anmolagarwal04/IC-Tester/design.pdf

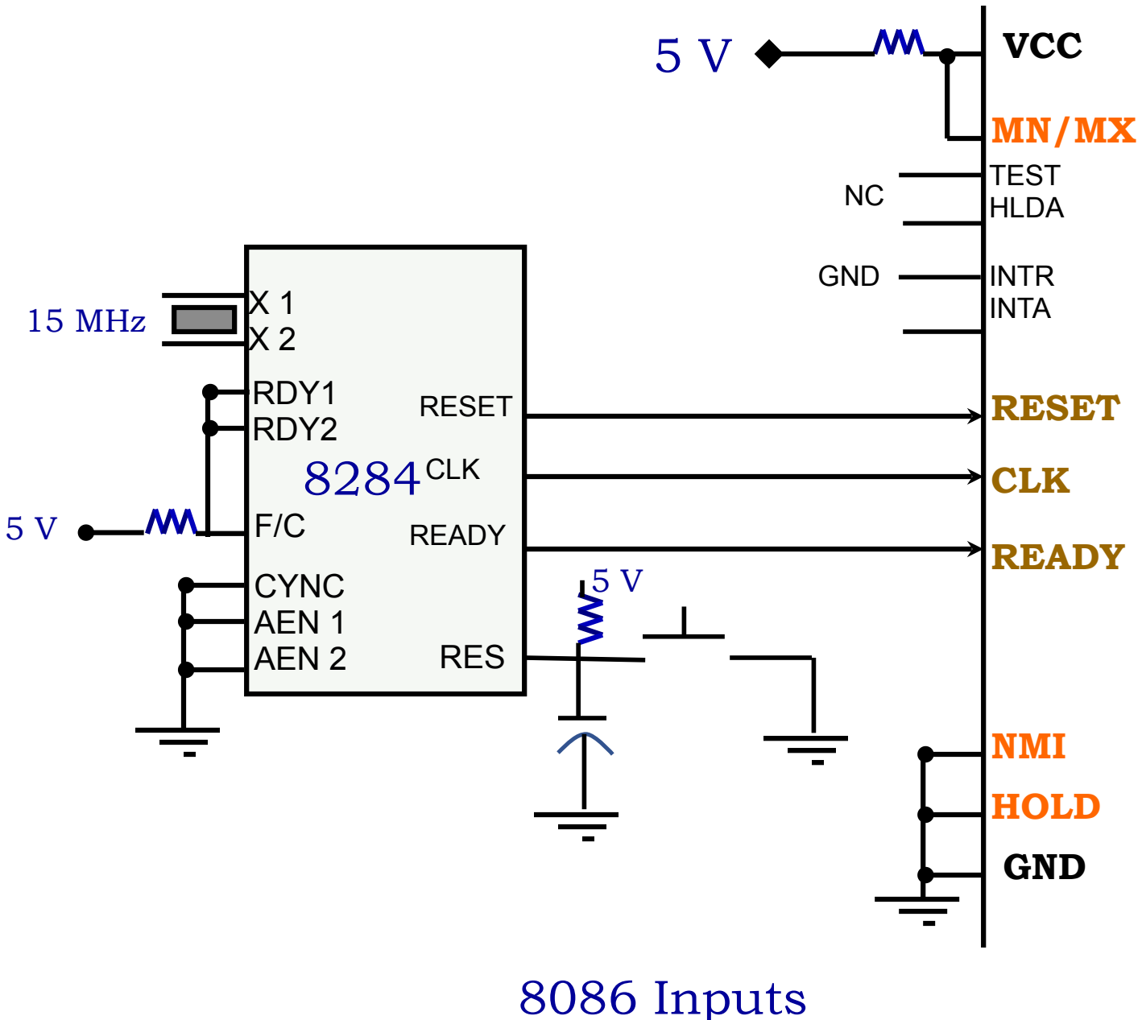
[picture p1: figure]
CLK; RESET; READY; VCC; GND; HOLD; NMI; 15 MHz; 8086 Inputs; CYNC AEN 1 AEN 2; RES; RDY1 RDY2; TEST HLDA; INTR INTA

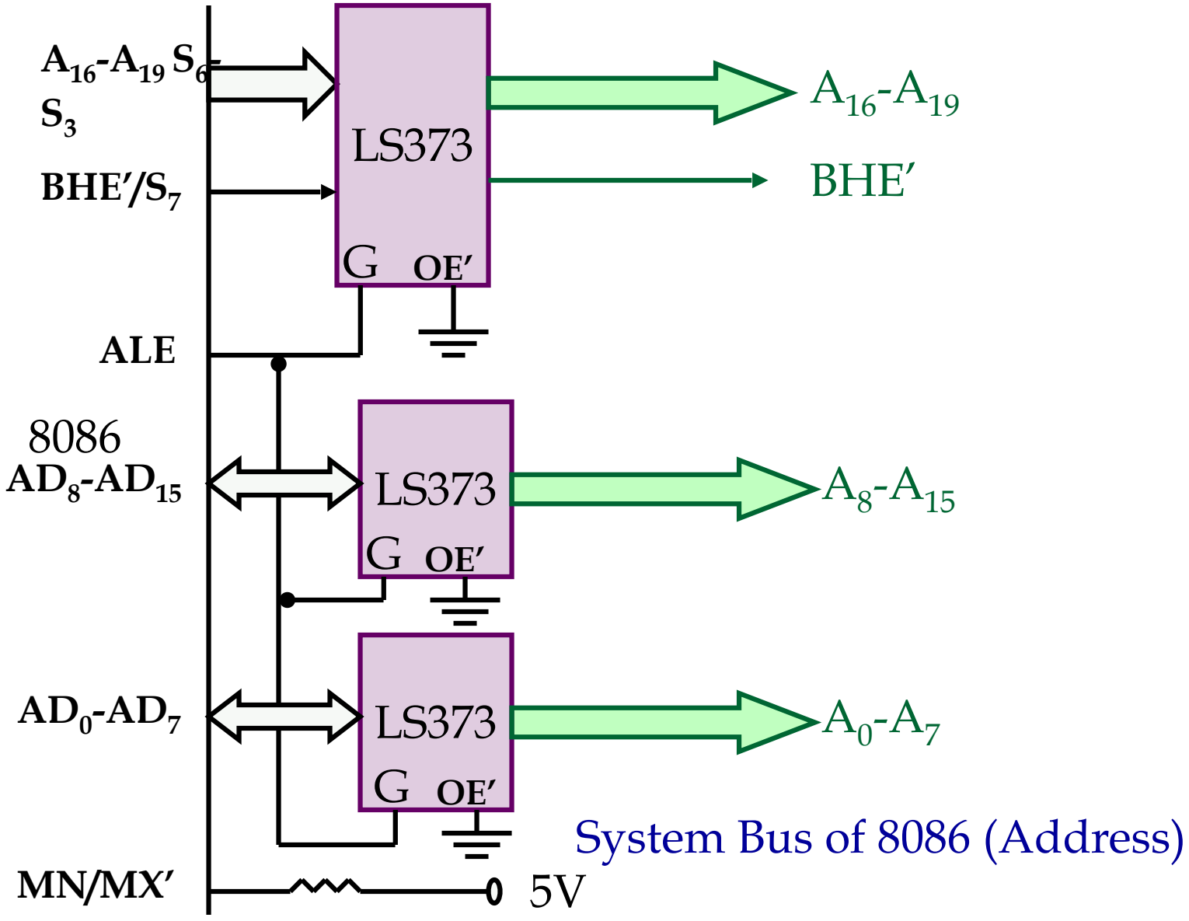
[picture p2: figure]
BHE’/S7; ALE; BHE’; System Bus of 8086 (Address)

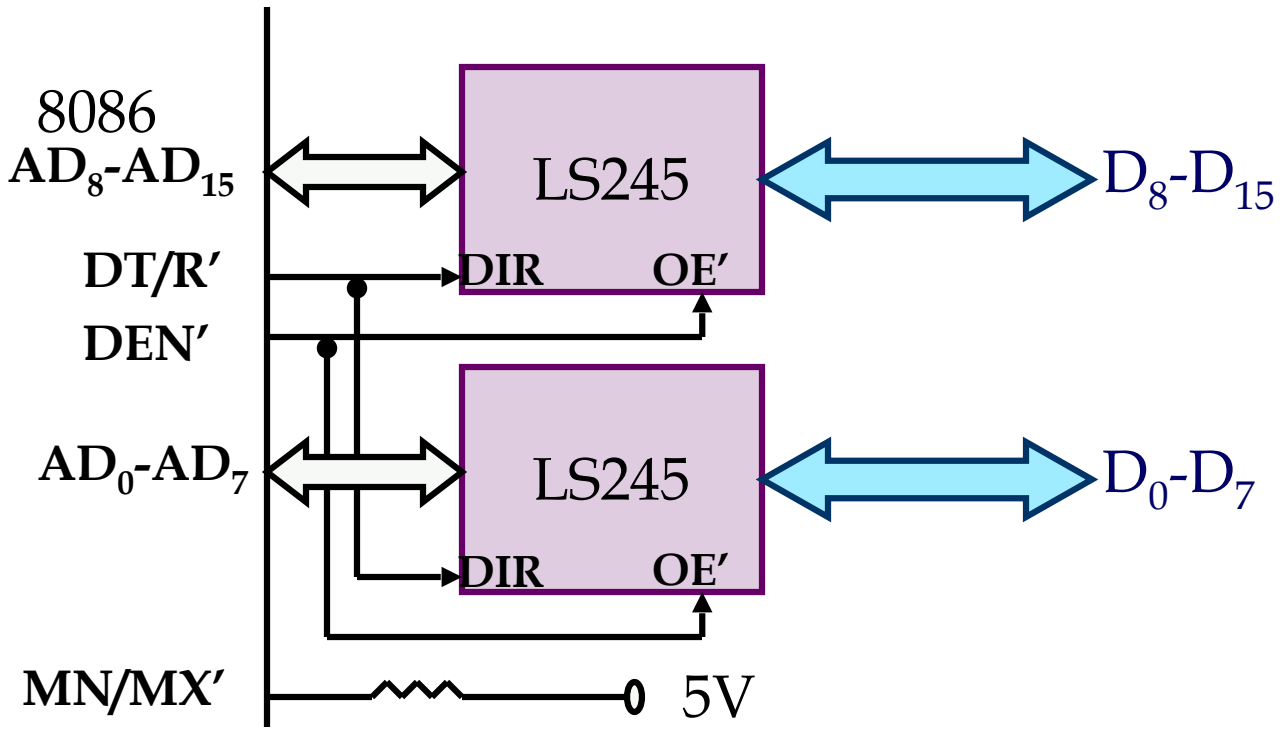
[picture p3: figure]
DIR; DT/R’ DEN’

System Bus of 8086(Data)

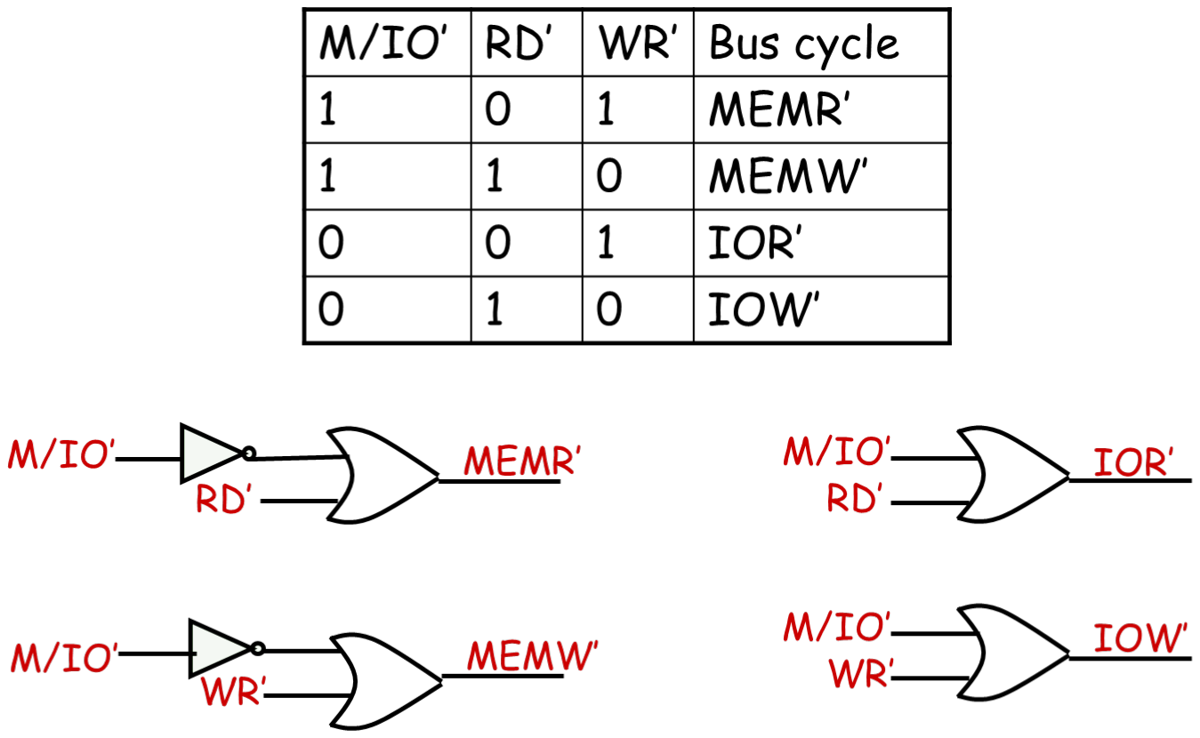
[picture p4: page 4]

LS138

GND

G2A G1

A0 | G2B

I2
I1
I0

A14
A13

A12

O1 RAME

O0

O7

ROM1E

ROM2E

VCC

Memory Decoder

LS138

GND

G2A G1

G2B

I2
I1
I0

A14

A13
A12

O1 RAMO

O0

O7

ROM1O

ROM2O

VCC BHE’

For Even Bank | For Odd Bank

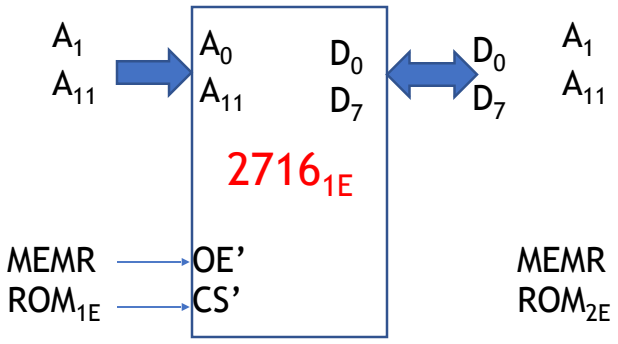
[picture p5: figure]
MEMR ROM1E; MEMR ROM2E
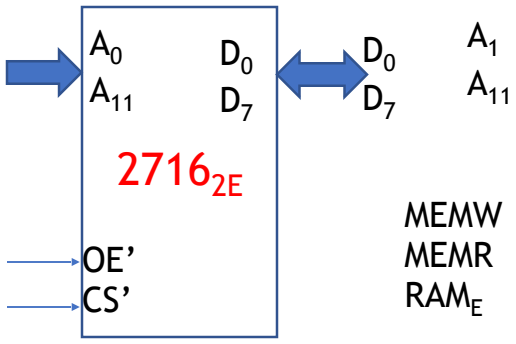
[picture p6: figure]
MEMW MEMR RAME
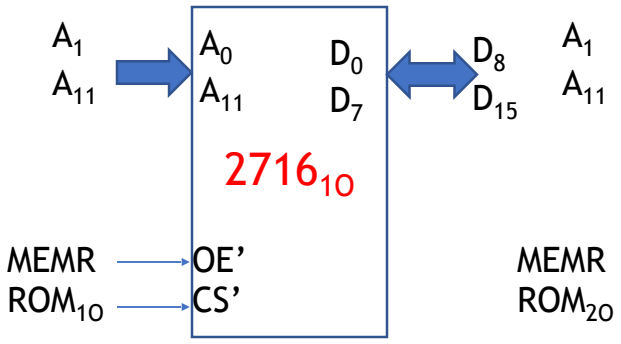
[picture p7: figure]
MEMR ROM1O; MEMR ROM2O
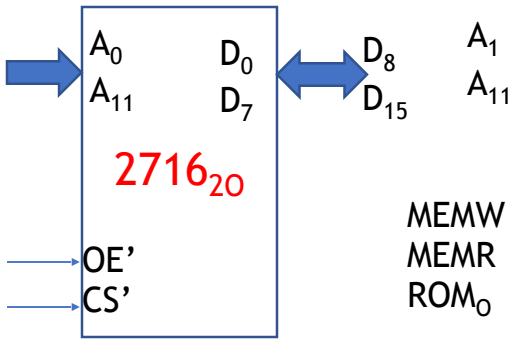
[picture p8: figure]
MEMW MEMR ROMO

Memory Interfacing

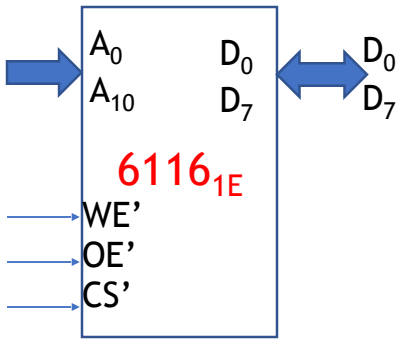
[picture p9: figure]
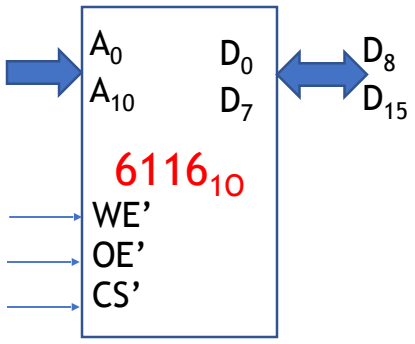
[picture p10: figure]

74HC139

I1
I0

A5
A4
O1 | 82552 CS’
O0 | 82551 CS’

I/O
Decoder

GND E

82551 Interface to the processor

8255

A0
A1

A1
A2

CS

RD
WR
D0 D0 | – D7 – D7

RESET RESET from 8284

82551 CS’

IOR
IOW

82552 Interface to the processor A0
A1

A1
A2

CS

RD
WR
D0 D0 | – D7 – D7

RESET RESET from 8284

82552 CS’

8255

IOR
IOW

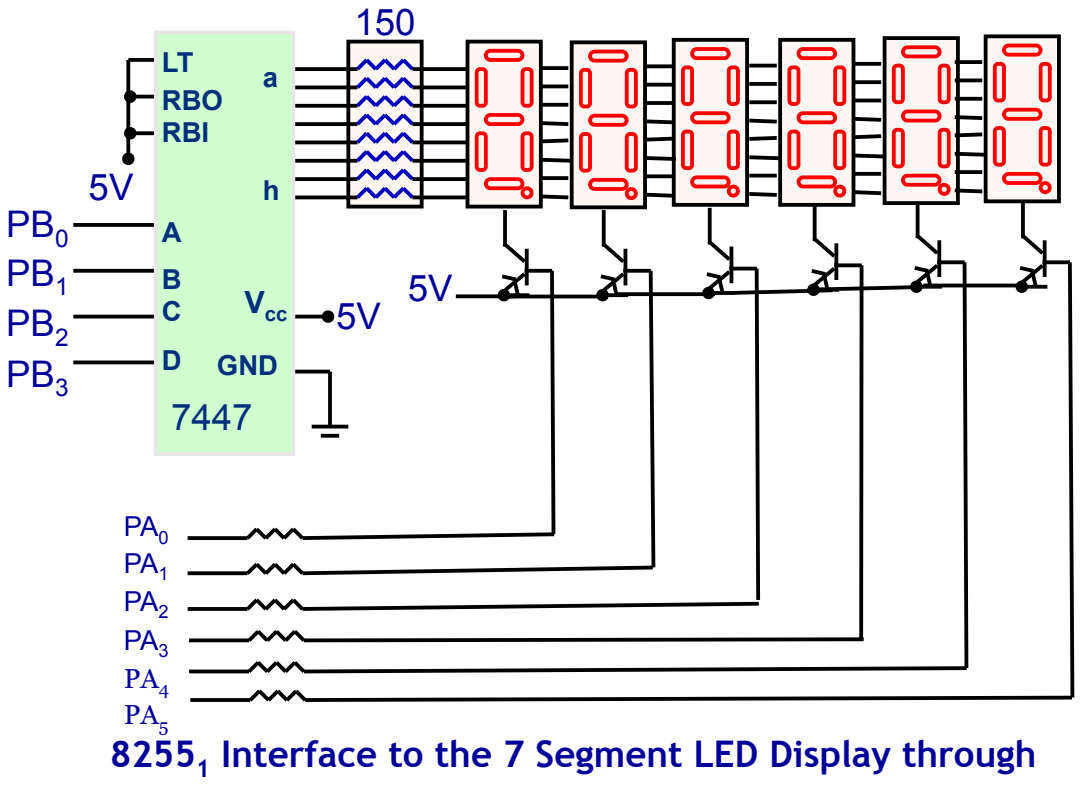
[picture p11: page 10]
LT RBO RBI; Vcc; GND; PA0 PA1 PA2 PA3 PA4 PA5 82551 Interface to the 7 Segment LED Display through 7447

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
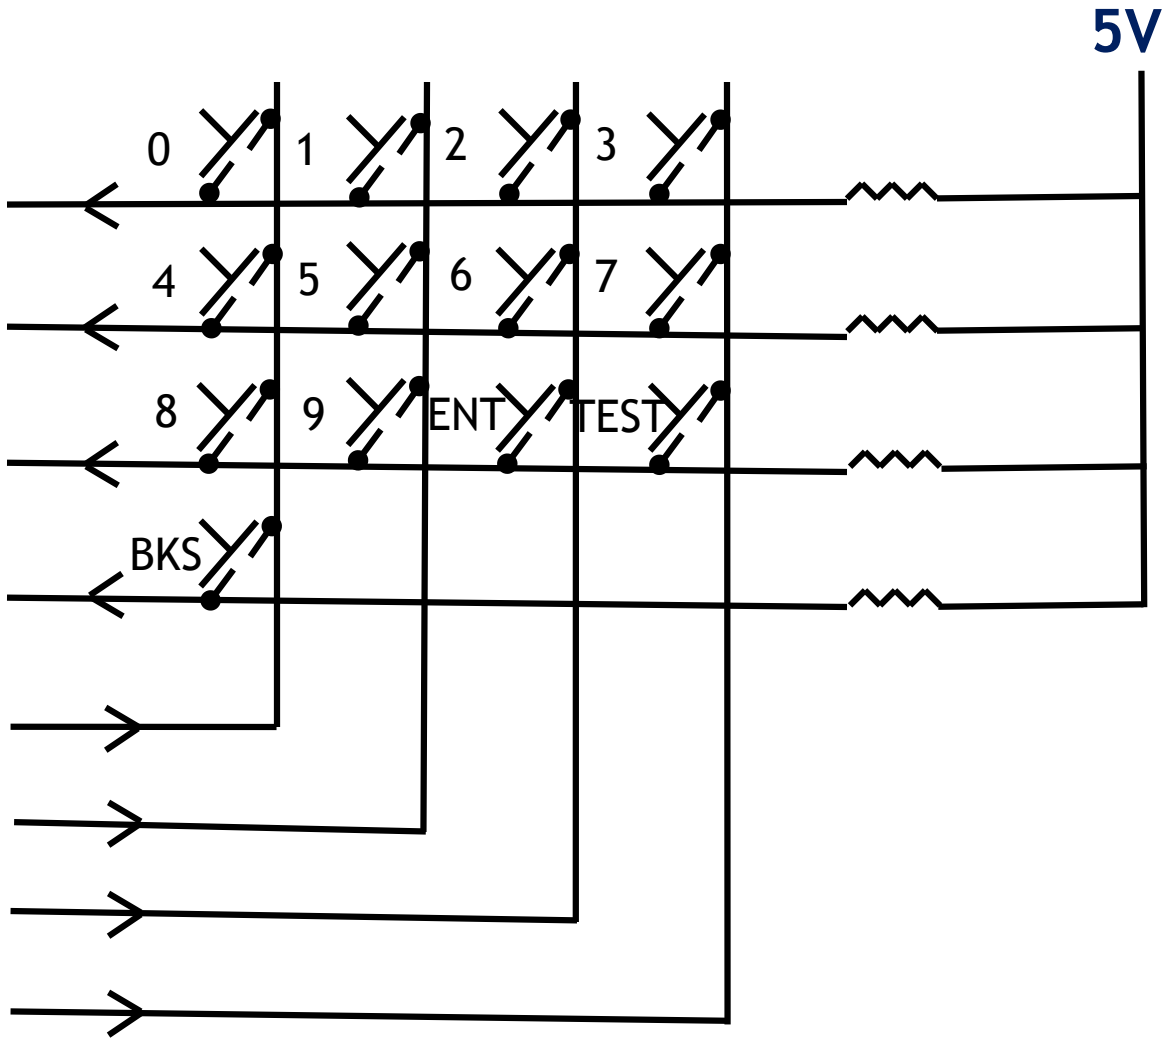
[picture p12: figure]
ENT; TEST; BKS

82551 Interface to the Hex Keypad

82552 Interface to the ZIF

ZIF

PC0 PC1 | PA3 | PC2 | PC3 | PA4
PC4 | PC5 | PA6 PC7 PA5 | PC6 | PA7

PB0
