anmolagarwal04/IC-Tester/(list of files, drawings)

Other design files:
ic_tester.DSN
